ayerone/lerobot-haptic-feedback/images/gimbal_motor.jpg

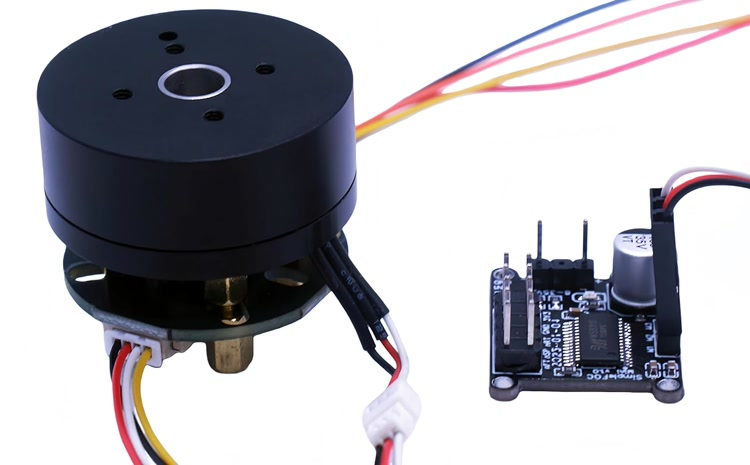
images/gimbal_motor.jpg
