ayerone/lerobot-haptic-feedback/lerobot_teleoperator_so_feedback_leader/lerobot_teleoperator_so_feedback_leader/config_so_feedback_leader.py

from dataclasses import dataclass

from lerobot.teleoperators.config import TeleoperatorConfig

@TeleoperatorConfig.register_subclass("so_feedback_leader")
@dataclass
class SOFeedbackLeaderConfig(TeleoperatorConfig):
    # Port to connect to the arm
    port: str

    # Port to connect the logsplitter
    feedback_port: str

    # Whether to use degrees for angles
    use_degrees: bool = False
