ayerone/lerobot-haptic-feedback/(commit log)

2026-06-05 Restructure into two packages and refactor feedback leader
    Split the single src/ package into separate lerobot_robot_so_sensor_arm
    and lerobot_teleoperator_feedback_leader packages, each with their own
    pyproject.toml. Extracted GripFeedbackController class from FeedbackLeader
    to own the feedback state and calculation logic, eliminating duplicated
    derivative envelope computation. Cleaned up imports, comments, and minor
    style issues in both feedback_leader.py and feedback_motor.py. Updated
    .gitignore to cover new package locations.
    [feedback_motor.ino, feedback_motor.py]
2026-06-05 Update README for two-package structure and current send_feedback implementation
2026-06-05 Remove vibration code; ship automatic grip force control
    Replace vibration-based haptic feedback with a P-controller that holds grip force at a setpoint of 20 (0–100 scale). Spring torque gives the operator tactile resistance. Operator can squeeze past the setpoint for intentional extra closure, and break auto-grip by opening the gimbal. Vibration design is preserved in vibration_feedback_design_log.md and git history.
2026-06-05 Sensorless haptic feedback via motor current and load
    Replace force sensor with follower gripper bus signals (Present_Current,
    Present_Load) as the feedback source. Sign of gimbal torque from load,
    magnitude from current. Stability achieved through EMA smoothing on inputs
    and output, gripper velocity weighting to distinguish motion current from
    contact force, and a velocity-weighted current lockout to prevent idle
    oscillation.
    Also adds signal correlation tooling (correlate_force_and_motor_load.py,
    analyze_force_motor_signals.py) and design logs (sensorless_design_log.md,
    to_sense_or_not_to_sense.md).
2026-06-07 Rename packages, overhaul README, add hero image
    - Rename so_sensor_arm → so_feedback_follower, feedback_leader → so_feedback_leader
    - Remove force sensor code; follower now reads Present_Current and Present_Load from stock servo
    - Remove Rerun logging from send_feedback; rename α → alpha
    - Overhaul README: rewrite use/backstory/glossary sections, add glossary links, add calibration instructions, add hero image
    - Add lerobot_record.py and lerobot_teleoperate.py patched examples
    - Add images: so_feedback_leader.jpg, rerun_noisy_current.png, true_grip.png
    - Add log/ to .gitignore; remove stale shell scripts and design log md files
    Worked with Claude
2026-06-07 Use img tags for images, crop force sensor photo
    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
2026-06-07 Fix force sensor image crop
    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
